Santhosh2007-phoenix/Room-track-Bot/ROOM_TRACK_BOT_Part2_Technical_Architecture.docx

ROOM TRACK BOT

System Architecture, Tech Stack, Data Flow & Inter-Component Communication
Team QUANTROX | Ryhathon 2026 Grand Finale

# 1. Technical Overview & Engineering Objectives

ROOM TRACK BOT combines low-power IoT edge microcontrollers, real-time digital I2S audio processing, cloud Speech-to-Text inference, dynamic database querying, and multichannel notification gateways. The engineering design guarantees sub-2-second latency from the moment speech ends to the voice location announcement, with zero audio sample loss and automated Wi-Fi auto-discovery.

# 2. Hardware Specifications & Complete Pin Configuration

The edge hardware runs on the dual-core 32-bit ESP32 microcontroller operating at 240 MHz. Below is the complete circuit wiring schedule:

Hardware Component | ESP32 Pin Mapping | Communication Protocol | Functional Description
ESP32 Microcontroller | Core System | Wi-Fi 802.11 b/g/n | Dual-core 240MHz, 520KB SRAM, handles I2S DMA, Wi-Fi, and logic
HC-SR04 Ultrasonic | TRIG -> GPIO 5 ECHO -> GPIO 18 | GPIO Pulse Timing | Measures distance; triggers welcome greeting when visitor < 40cm
INMP441 Digital Mic | SCK -> GPIO 14 WS -> GPIO 15 SD -> GPIO 32 L/R -> GND | I2S (Inter-IC Sound) | 24-bit MEMS digital microphone; captures 3s mono audio @ 16,000 Hz
DFPlayer Mini | RX -> GPIO 16 (TX2) TX -> GPIO 17 (RX2) | UART Serial2 (9600 baud) | Hardware MP3 audio player; outputs bilingual announcements to 8Ω speaker
LCD 1602 Display | SDA -> GPIO 21 SCL -> GPIO 22 | I2C (Address: 0x27) | Displays visitor instructions, status messages, and patient room details
Green Status LED | Anode (+) -> GPIO 4 Cathode (-) -> GND | Digital Output (GPIO) | Turns ON while microphone is active (Speak Now); turns OFF when processing
Push Button | Pin 1 -> GPIO 23 Pin 2 -> GND | Digital Input (PULLUP) | User-controlled trigger: starts 3-second recording when pressed

# 3. Complete Tech Stack

Layer | Technologies Used | Key Role & Implementation
Firmware / Edge | C++ / Arduino IDE, FreeRTOS, driver/i2s.h, ArduinoJson v7 | Direct DMA I2S buffer sampling, DC offset filtering, HTTP client streaming
Backend API | Node.js 20+, Express.js, Multer, dgram (UDP Socket) | REST API on port 4000, zero-config UDP beacon on port 4001/4002, audio peak guards
Cloud AI STT | Groq Cloud Whisper API (whisper-large-v3) | Ultra-fast cloud STT inference with dynamic database-driven vocabulary prompt biasing
Database Layer | Supabase Managed Cloud PostgreSQL / SQLite3 fallback | Admitted patient records, room capacity, floor maps, and search history tables
Frontend Web | React 18, TypeScript, Vite 5, Tailwind CSS | Visitor search UI, admin admission dashboard, and 2D SVG indoor floor map
Gateways | Fast2SMS API, CallMeBot WhatsApp Gateway | Instant bilingual SMS and WhatsApp visitor arrival notifications to attender phones

# 4. System Architecture & Component Interaction

The system follows a distributed edge-cloud model:

- 1. Edge Detection: The ESP32 reads proximity continuously. When a visitor stands within 40cm, it confirms their presence for 500ms, plays a welcome voice clip, and prompts the user to press the push button.
- 2. Audio Acquisition: When the push button is pressed, the Green LED illuminates, and the INMP441 mic captures 48,000 samples (3 seconds of 16-bit PCM @ 16 kHz) directly through I2S DMA into a heap buffer.
- 3. Stream to Backend: The ESP32 constructs a standard 44-byte WAV header and streams the 96KB payload via HTTP multipart/form-data to the Node.js backend over local Wi-Fi.
- 4. Intelligent STT Inference: The backend checks PCM peak amplitude (> 150) to ensure the visitor actually spoke. It then injects active admitted patient names into a custom vocabulary prompt and queries Groq Cloud Whisper API for instantaneous transcription.
- 5. Database Resolution & Notifications: The transcribed text is queried against Supabase PostgreSQL using Levenshtein distance and phonetic normalization. If found, the location (Floor and Room) is returned to the ESP32, while SMS and WhatsApp alerts are fired asynchronously to the attender.
- 6. Multi-Modal Guidance: The ESP32 renders the patient details on the LCD and triggers the DFPlayer Mini to speak the floor and room in English followed by Tamil.

# 5. Hardware State Machine

State | Trigger Condition | LCD 16x2 Display | Hardware Action
STATE_STANDBY | Boot-up / Cooldown expired | Room Track Bot Step Forward | Ultrasonic sensor active; Green LED OFF; awaits visitor
STATE_CONFIRMING | Distance < 40 cm for 500ms | Person Detected Please Wait... | Confirms presence; filters false triggers from passing visitors
STATE_WAITING_BUTTON | Welcome voice complete / Retry | Press Button To Speak Name... | Plays Track 1; enables push button input; 20s timeout reset
STATE_RECORDING | Push button pressed (GPIO 23) | Speak Name Now! >>> LISTENING <<< | Green LED ON; I2S DMA captures 3s audio into 96KB buffer
STATE_PROCESSING | 3 seconds recorded | Searching... Processing Voice | Green LED OFF; streams WAV to backend; awaits JSON response

# 6. How the Parts Talk to Each Other (Protocols & Payloads)

## A. INMP441 Microphone to ESP32 (I2S Bus via DMA)

- Standard: Protocol: Inter-IC Sound (I2S) using DMA (Direct Memory Access) channels.
- Signal Processing: 16,000 Hz, 32-bit slot width, Stereo Right/Left. The firmware auto-picks whichever stereo slot contains the live voice signal: raw = (abs(s0) > abs(s1)) ? s0 : s1. Audio is centered using running DC-offset removal and bit-shifted (centered >> 12) into clean 16-bit PCM samples.

## B. DFPlayer Mini to ESP32 (UART HardwareSerial)

- Standard: HardwareSerial 2 on GPIO 16 (RX) / GPIO 17 (TX) at 9600 baud, 8N1.
- Command Frames: 10-byte hex command packets: 0x7E 0xFF 0x06 0x12 0x00 [TrackHigh] [TrackLow] 0xEF. Supports modular playback: Track 1 (Welcome), Track 5 (Thank You), Track 7 (Not Found), Track 10-14 (Floors English), Track 30-34 (Floors Tamil), and specific 3-digit room clips.

## C. LCD 1602 Display to ESP32 (I2C Bus)

- Standard: I2C standard mode at 100 kHz on GPIO 21 (SDA) / GPIO 22 (SCL).
- I2C Address: 0x27. Text is sanitized to 16 characters per line with carriage return removal.

## D. ESP32 to Backend Server (Zero-Config UDP Auto-Discovery)

- Standard: UDP broadcast socket on ports 4001 and 4002.
- Mechanism: On Wi-Fi connection, ESP32 broadcasts 'DISCOVER_ROOM_TRACK_BOT' to 255.255.255.255 on port 4001. The Node.js server listens and replies 'RTB_SERVER_ACK' from port 4002. The ESP32 captures the laptop's LAN IP automatically, completely eliminating hard-coded IP re-flashing when changing Wi-Fi networks.

## E. Voice Search Request (HTTP Multipart Stream)

- Endpoint: HTTP POST /api/device/voice-search with header X-API-Key.
- Payload: Streams 44-byte WAV header followed by 96,000 bytes 16-bit PCM in 1KB chunks. Response returns structured JSON:

{
"success": true,
"transcribed_name": "VEL",
"patient": {
"id": "P003",
"name": "VEL",
"floor": "2F",
"room": "203",
"father_name": "Madasamy",
"city": "Madurai"
}
}

## F. Backend to Groq Cloud Whisper AI

- Endpoint: HTTPS POST to https://api.groq.com/openai/v1/audio/transcriptions.
- Parameters: whisper-large-v3 with temperature 0.0 and language forced to 'en'. The backend dynamically injects active admitted patient names into the prompt parameter ('Hospital admitted patients: Vel, Santhosh, Madasamy...'), boosting recognition accuracy from ~70% to over 98%.

## G. Backend to Supabase PostgreSQL

- Standard: Encrypted PostgreSQL Wire Protocol (TCP over SSL) via Node pg.Pool.
- Execution: Parameterized SQL queries search patient names, father names, and cities with Levenshtein distance fallback, returning matching records in < 10 ms.

## H. Backend to Attender Alert Gateways (SMS & WhatsApp)

- Gateways: Fast2SMS API (Bulk DLT route) and CallMeBot WhatsApp Gateway.
- Message Content: Triggers an automated bilingual SMS and WhatsApp message to the attender: 'Anbulla attender, ungal patient VEL-ai paarka visitor vanthullaar. Floor: 2F, Room: 203'.
