Santhosh2007-phoenix/Room-track-Bot/ROOM_TRACK_BOT_Circuit_and_Block_Diagrams.docx

ROOM TRACK BOT

Block Diagram, Circuit Schematics & Complete Hardware Wiring Guide
Team QUANTROX | Ryhathon 2026 Grand Finale

# 1. System Block Diagram

The ROOM TRACK BOT hardware edge unit is built around the dual-core ESP32 microcontroller. The system is segregated into four functional domains: (1) Sensing & User Trigger, (2) Audio Processing & I2S Acquisition, (3) Visual & Bilingual Audio Guidance, and (4) Cloud Networking.

+---------------------------------------------------------------------------------------+

| ROOM TRACK BOT - SYSTEM BLOCK DIAGRAM |

+---------------------------------------------------------------------------------------+

[ POWER INPUT: 5V DC via Micro-USB / External 5V 2A Regulated Adapter ]

+-------------------+--------------------+--------------------+

| (5V) | (5V) | (5V) | (3.3V)

v v v v

+------------+ +------------+ +------------+ +---------------+

| HC-SR04 | | DFPLAYER | | LCD 1602 | | INMP441 |

| ULTRASONIC | | MINI AUDIO | | (I2C 0x27) | | DIGITAL MIC |

+------------+ +------------+ +------------+ +---------------+

| (Trig/Echo) | (UART Serial2) | (I2C Bus) | (I2S DMA Bus)

| GPIO 5, 18 | GPIO 16, 17 | GPIO 21, 22 | GPIO 14, 15, 32

v v v v

+---------------------------------------------------------------------------+

| ESP32-WROOM-32 MAIN CONTROLLER |

| (Dual-Core Xtensa LX6 @ 240 MHz, 520 KB SRAM, Wi-Fi 802.11 b/g/n) |

+---------------------------------------------------------------------------+

^ ^ ^

| (Active LOW) | (Digital Out) | (2.4 GHz Wi-Fi)

| GPIO 23 | GPIO 4 | HTTP REST / UDP

| | v

+------------+ +------------+ +------------------------------------+

| PUSH BUTTON| | STATUS LED | | NODE.JS BACKEND SERVER (:4000) |

| (INPUT_ | | (Green - | | - Groq Cloud Whisper STT AI |

| PULLUP) | | Speak Now) | | - Supabase PostgreSQL DB |

+------------+ +------------+ | - Fast2SMS & WhatsApp Alerts |

+------------------------------------+

# 2. Comprehensive Pin-to-Pin Circuit Connection Schedule

Every connection between the ESP32 and peripheral sensors, actuators, and power rails is specified below:

Module / Sensor | Module Pin | ESP32 Pin | Signal / Protocol | Circuit Notes & Resistors
HC-SR04 Ultrasonic | VCC GND TRIG ECHO | 5V (VIN) GND GPIO 5 GPIO 18 | Power (5V) Ground Digital Output Pulse Input (3.3V) | ECHO pin uses a 1kΩ / 2kΩ voltage divider to step 5V down to safe 3.3V for ESP32.
INMP441 Digital Mic | VDD GND SCK WS SD L/R | 3.3V GND GPIO 14 GPIO 15 GPIO 32 GND | Power (3.3V ONLY) Ground I2S BCLK I2S LRCK I2S DIN Channel Select | Connect VDD ONLY to 3.3V. Connecting to 5V will burn the MEMS sensor. L/R to GND configures Left channel mono.
DFPlayer Mini | VCC GND RX TX SPK_1 SPK_2 | 5V (VIN) GND GPIO 17 (TX2) GPIO 16 (RX2) Speaker (+) Speaker (-) | Power (5V) Ground UART Serial2 In UART Serial2 Out Analog Audio Out Analog Audio Out | ESP32 TX (GPIO 17) connects to DFPlayer RX through a 1kΩ resistor to eliminate audio noise. Connects to 8Ω 2W/3W speaker.
LCD 1602 (I2C Backpack) | VCC GND SDA SCL | 5V (VIN) GND GPIO 21 GPIO 22 | Power (5V) Ground I2C Data I2C Clock | PCF8574 backpack communicates at address 0x27. Contrast potentiometer on back adjusts character sharpness.
Green Status LED | Anode (+) Cathode (-) | GPIO 4 GND | Digital Output Ground | Uses 220Ω / 330Ω current-limiting resistor between GPIO 4 and LED Anode. Lights up only during voice recording.
Push Button (Voice Trigger) | Terminal 1 Terminal 2 | GPIO 23 GND | Digital Input Ground | Firmware uses pinMode(23, INPUT_PULLUP). When pressed, pin reads LOW. No external resistor needed.

# 3. Detailed Module-by-Module Circuit Schematics

## A. HC-SR04 Ultrasonic Sensor & 3.3V Logic Voltage Divider

The HC-SR04 requires 5V VCC to emit high-intensity 40 kHz ultrasonic pulses. Its ECHO pin outputs a 5V logic pulse. Because the ESP32 GPIO pins are rated for 3.3V maximum, directly connecting the 5V ECHO pulse can degrade or destroy the ESP32 pin. We implement a passive 1kΩ / 2kΩ resistive voltage divider:

+5V VCC

+-------+-------+

| HC-SR04 |

| ULTRASONIC |

| SENSOR |

+---------------+

TRIG ECHO

GPIO 5 <-----+ |

[1 kΩ Resistor (R1)]

+------> GPIO 18 (Safe 3.3V Logic)

[2 kΩ Resistor (R2)]

GND

Voltage formula: V_out = 5V * (2kΩ / (1kΩ + 2kΩ)) = 3.33V, which safely matches the ESP32 logic threshold.

## B. INMP441 Digital MEMS Microphone (I2S Audio Bus)

The INMP441 is an omnidirectional MEMS microphone with an integrated 24-bit analog-to-digital converter (ADC) and an industry-standard I2S serial audio interface. Unlike noisy analog electret microphones, it communicates digitally without picking up Wi-Fi RF interference:

ESP32 PINS INMP441 MODULE

+----------------+ +----------------+

| 3.3V |---------------->| VDD (3.3V ONLY)|

| GND |---------------->| GND |

| GPIO 14 (BCLK) |---------------->| SCK (Clock) |

| GPIO 15 (LRCK) |---------------->| WS (Word Select|

| GPIO 32 (DIN) |<----------------| SD (Serial Data|

| GND |---------------->| L/R (Left Ch) |

+----------------+ +----------------+

- Important Wiring Note: VDD must connect to 3.3V only (never connect to 5V).
- Important Wiring Note: L/R pin tied to GND sets the microphone output to the Left channel stereo slot.

## C. DFPlayer Mini Audio Player & 8Ω Speaker

The DFPlayer Mini decodes MP3 files from a micro-SD card and outputs amplified analog audio directly to a 2W or 3W 8Ω speaker:

ESP32 PINS DFPLAYER MINI

+----------------+ +----------------+

| 5V (VIN) |---------------->| VCC (Pin 1) |

| GND |---------------->| GND (Pin 7/10) |

| GPIO 17 (TX2) |---[ 1 kΩ ]----->| RX (Pin 2) |

| GPIO 16 (RX2) |<----------------| TX (Pin 3) |

+----------------+ | SPK_1 (Pin 6) |---+ [Speaker +]

| SPK_2 (Pin 8) |---+ [Speaker -]

+----------------+

- Crucial Audio Fix: The 1kΩ series resistor between ESP32 TX2 (GPIO 17) and DFPlayer RX absorbs voltage level differences and prevents high-frequency digital switching noise from bleeding into the speaker.

## D. LCD 1602 Display with PCF8574 I2C Backpack

The 16-character by 2-line alphanumeric LCD uses a PCF8574 I2C backpack board, reducing the required control lines from 16 to just 2 I2C wires:

ESP32 PINS LCD 1602 (I2C)

+----------------+ +----------------+

| 5V (VIN) |---------------->| VCC |

| GND |---------------->| GND |

| GPIO 21 (SDA) |---------------->| SDA |

| GPIO 22 (SCL) |---------------->| SCL |

+----------------+ +----------------+

- Adjustment: The onboard potentiometer on the blue backpack adjusts the contrast of the 16x2 text. If blank blocks appear, rotate the trimmer with a screwdriver.

## E. Green Indicator LED (Speak Now Visual Cue)

ESP32 GPIO 4 ----[ 220 Ω / 330 Ω Resistor ]----( + ) LED Anode

( - ) LED Cathode ---- GND

- Operation: Software logic: Turns ON at the start of recordAndSearchVoice() and turns OFF immediately when 3 seconds finish.

## F. Push Button (Voice Input Trigger)

ESP32 GPIO 23 ----[ Push Button Switch ]---- GND

(Internal pull-up resistor enabled: pinMode(23, INPUT_PULLUP))

- Operation: When unpressed: GPIO 23 reads HIGH (3.3V). When pressed: GPIO 23 reads LOW (0V). Software debounces with a 150ms delay.

# 4. Power Architecture & Decoupling Strategy

The system uses a single unified 5V DC power supply (Micro-USB or 5V 2A wall adapter):

- 5V Distribution: 5V Rail: Powers the DFPlayer Mini (needs high peak current during speaker audio bursts), the LCD 1602 backlight, and the HC-SR04 ultrasonic sensor.
- 3.3V Distribution: 3.3V Rail: Generated by the ESP32's onboard AMS1117 / ME6211 low-dropout (LDO) regulator. Powers the ESP32 microcontroller core and the INMP441 digital microphone.
- Common Ground Bus: Common Ground (GND): All grounds (ESP32 GND, Sensor GND, DFPlayer GND, LCD GND, and Button GND) are tied to a single common ground bus to avoid floating ground loops and audio buzz.
