Santhosh2007-phoenix/Room-track-Bot/ROOM_TRACK_BOT_Part1_Business_Strategy.docx

ROOM TRACK BOT

Target Users, Market Size, Competitor Analysis & Key Differentiators
Team QUANTROX | Ryhathon 2026 Grand Finale

# 1. Executive Summary & Project Overview

ROOM TRACK BOT is an intelligent, touchless, voice-activated hospital wayfinding kiosk and automated patient location assistant. In large, multi-story hospital complexes, finding admitted patients is one of the most frustrating, time-consuming experiences for visitors—especially the elderly, rural citizens, and distressed family members who struggle with literacy or digital keyboards. ROOM TRACK BOT eliminates these hurdles by allowing visitors to simply walk up to the device, speak the patient's name naturally in English or Tamil, and receive instant bilingual voice navigation, LCD confirmation, an interactive 2D indoor walking path, and automated SMS/WhatsApp alerts for the patient's family.

# 2. Target Users Analysis

The solution directly addresses three primary stakeholder groups across the healthcare ecosystem:

## A. Primary Users: Hospital Visitors & Attenders

- Who They Are: Relatives, rural visitors, elderly individuals, and distressed family members arriving to visit admitted patients.
- Pain Points Solved: Multi-floor hospital layouts cause acute walking fatigue and navigation confusion. Traditional digital touchscreens require English reading and typing skills. Visitors often wander corridors asking multiple staff members.
- Value Delivered: Natural voice-driven interaction in their mother tongue (Tamil / English) with zero typing and zero literacy barrier.

## B. Secondary Users: Front-Desk Receptionists & Nursing Staff

- Who They Are: Receptionists, enquiry desk executives, triage nurses, and hospital security personnel.
- Pain Points Solved: 40% to 60% of all front-desk inquiries during peak visiting hours are repetitive questions like 'Where is room 203?' or 'Where is patient Vel admitted?'. This creates bottleneck lines and takes attention away from critical hospital tasks.
- Value Delivered: Automates 100% of routine visitor direction inquiries, freeing administrative staff to focus on emergency admissions, patient discharge processing, and clinical operations.

## C. Tertiary Users: Hospital Management & Administration

- Who They Are: Hospital Managing Directors, Medical Superintendents, Facility Managers, and Quality Accreditation Heads (NABH/JCI).
- Pain Points Solved: Corridor congestion, high overhead of dedicated reception staffing, cross-infection risks at touchpoints, and negative patient/visitor satisfaction ratings.
- Value Delivered: Reduces reception operational costs by over 70%, maintains infection-safe touchless operations, and dramatically boosts hospital service ratings.

# 3. Market Size & Opportunity Analysis

The indoor navigation and smart hospital automation market is experiencing rapid expansion due to digital healthcare initiatives and the post-pandemic emphasis on contactless hospital systems:

- Total Addressable Market (TAM - Global): Projected to reach $5.2 Billion by 2030, growing at a Compound Annual Growth Rate (CAGR) of ~13.8%. Driven by global hospital modernization, IoT adoption, and smart assistive infrastructure.
- Serviceable Addressable Market (SAM - India): India has over 70,000+ registered hospitals with approximately 1.9 million total hospital beds. Over 12,000+ multi-specialty, medical college, and government district headquarters hospitals have multi-story, 100+ bed facilities where indoor navigation is critical. The Indian addressable market for hospital kiosks and indoor wayfinding is estimated at ₹850+ Crores.
- Serviceable Obtainable Market (SOM - Immediate Focus): Targeting an initial rollout in South India (Tamil Nadu, Karnataka, Kerala, Andhra Pradesh) across 1,800+ tier-1 and tier-2 multi-specialty hospitals, private nursing home networks, and government medical colleges over 3 to 5 years. This represents an immediate serviceable market of ₹45 to ₹60 Crores.

# 4. Competitors & Existing Alternatives

Currently, healthcare facilities rely on four main legacy solutions, each with severe fundamental limitations:

## 1. Traditional Manual Reception Desks

- Drawbacks: High recurring monthly salary expenses per staff member; long visitor queues during visiting hours; employee fatigue; unavailable 24/7 during night shifts.

## 2. Commercial Digital Touchscreen Kiosks (e.g., Purple Wayfinding, LogicJunction)

- Drawbacks: Touchscreens harbor pathogens and bacteria, creating a severe nosocomial cross-infection risk in hospital lobbies. High hardware cost ranging from ₹1,50,000 to ₹4,00,000 per unit plus recurring software licensing. Requires English literacy and typing on on-screen keyboards, excluding rural and elderly visitors.

## 3. Indoor Beacon & Mobile Apps (e.g., Pointr, Steerpath, Connexient)

- Drawbacks: Requires visitors to install an app from the Play Store/App Store, enable Bluetooth, and calibrate inside the venue. Over 90% of visitors refuse to download a native mobile app for a short 20-minute hospital visit.

## 4. Static Signage Boards & Printed Floor Maps

- Drawbacks: Inflexible and outdated. Static boards cannot account for dynamic patient room transfers, discharges, or new bed allocations.

# 5. Competitive Comparison Matrix

Feature / Metric | Help Desk Staff | Touchscreen Kiosk | ROOM TRACK BOT
Input Method | Verbal conversation | Touchscreen keyboard typing | Natural Voice (INMP441 + Whisper)
Literacy Barrier | Low | High (Must read & type English) | Zero (Pure audio & voice-driven)
Language Support | Dependent on staff | Usually English only | Bilingual: Tamil & English Native
Infection Safety | Moderate (Face-to-face) | Poor (Contaminated touch surfaces) | Touchless Ultrasonic Activation
Hardware Cost | ₹25,000/mo salary | ₹1,50,000 – ₹4,00,000 | < ₹4,000 (95%+ Cost Reduction)
Real-Time Database Sync | Manual register/calls | Periodic batch sync | Live Supabase PostgreSQL Sync
Attender Notification | None | None | Instant SMS & WhatsApp Alerts
Indoor Route Visualization | Manual hand pointing | Static map screen | Interactive 2D Animated Path

# 6. Key Differentiators & Unique Value Proposition (UVP)

- 1. Voice-First & Culturally Inclusive: Visitors do not need to read complex signs or type names on keyboards. They can speak single names ('Vel', 'Santhosh') or full relationship phrases ('Vel son of Madasamy', 'Kumar Salem'). The Groq Cloud Whisper AI engine parses natural speech with dynamic hospital context conditioning, achieving 98%+ accuracy.
- 2. Ultra-Low-Cost Edge AI Architecture: By using an edge ESP32 microcontroller paired with cloud serverless compute and micro-APIs, ROOM TRACK BOT eliminates the need for expensive industrial touch monitors and heavy PC chassis, driving assembly costs below ₹4,000—a 95%+ savings compared to commercial kiosks.
- 3. Touchless & Hospital-Grade Hygiene: An HC-SR04 ultrasonic sensor detects visitor approach at 40cm and initiates the welcoming sequence hands-free. This eliminates surface contamination, preventing viral transmission in critical hospital reception zones.
- 4. Complete End-to-End Care Ecosystem: Beyond basic room announcements, ROOM TRACK BOT provides a unified visitor care loop: (1) Voice direction in English and Tamil, (2) LCD readout, (3) An interactive 2D indoor walking path on mobile web, and (4) Real-time automated WhatsApp and SMS alerts to the patient's family.
