Santhosh2007-phoenix/Room-track-Bot/ROOM_TRACK_BOT_Power_Budget_and_Safety_Notes.docx

ROOM TRACK BOT

Power Budget, Consumption Analysis, Battery Life & Hospital Safety Notes
Team QUANTROX | Ryhathon 2026 Grand Finale

# 1. Power Supply Architecture & Voltage Distribution

The ROOM TRACK BOT hardware kiosk is engineered to run from either a stationary AC wall adapter or a portable rechargeable battery pack. The system incorporates a dual-voltage distribution rail (5V and 3.3V) to balance the high peak currents demanded by audio amplification with the low-noise requirements of digital MEMS microphone acquisition:

- 1. Primary Power Input: Input Voltage: 5.0V DC (±0.25V) regulated input delivered via standard Micro-USB or external DC jack.
- 2. 5V High-Current Rail: Supplies the DFPlayer Mini MP3 audio amplifier, the LCD 1602 LED backlight, and the HC-SR04 ultrasonic sonic transducer.
- 3. 3.3V Low-Noise Logic Rail: Generated by the ESP32 dev board's onboard Low-Dropout (LDO) regulator (AMS1117-3.3 / ME6211). Supplies the dual-core 240MHz ESP32 processor, Wi-Fi baseband radio, and the sensitive INMP441 digital microphone.
- 4. Common Ground Bus: All component grounds are unified on a single star-ground bus to eliminate audio buzzing caused by digital return current ground loops.

# 2. Itemized Module Power Consumption & Current Budget

The table below details the operating voltage, idle current, peak operating current, and calculated power dissipation for every hardware component across all operational states:

Module / Component | Operating Voltage | Standby / Idle Current | Active / Peak Current | Peak Power Consumption
ESP32-WROOM-32 | 3.3V | 80 mA (Wi-Fi connected) | 240 mA (Wi-Fi TX burst) | 792 mW (0.79 W)
INMP441 Digital Mic | 3.3V | 0.012 mA (Standby) | 1.4 mA (I2S DMA Active) | 4.6 mW (0.005 W)
HC-SR04 Ultrasonic | 5.0V | 2.0 mA (Quiescent) | 15 mA (40kHz Sonic burst) | 75 mW (0.075 W)
DFPlayer Mini + Speaker | 5.0V | 20 mA (Idle / Muted) | 220 mA (Speaking @ 8Ω) | 1,100 mW (1.10 W)
LCD 1602 + I2C Backpack | 5.0V | 25 mA (Backlight ON) | 28 mA (Displaying text) | 140 mW (0.14 W)
Green Status LED | 3.3V (GPIO 4) | 0.0 mA (OFF in Standby) | 10 mA (ON during speak) | 33 mW (0.033 W)
Push Button Switch | 3.3V (GPIO 23) | 0.0 mA (Open circuit) | 0.07 mA (Pull-up active) | 0.2 mW (Negligible)
TOTAL SYSTEM CONSUMPTION | 5.0V Rail | 127 mA (Idle Standby) | 514 mA (Peak Burst) | 2.14 W (Typical Peak)

# 3. System Operational States & Power Summary

- State 1: Standby Monitoring: Ultrasonic active, LCD displays 'Step Forward', Wi-Fi connected, DFPlayer idle, LED OFF. Total current: ~127 mA @ 5V -> 0.635 W.
- State 2: Visitor Approaching: Ultrasonic pinging continuously for 500ms confirmation. Total current: ~135 mA @ 5V -> 0.675 W.
- State 3: Voice Recording (3 Seconds): Green LED ON, INMP441 I2S DMA active, ESP32 CPU at 240MHz, LCD active. Total current: ~165 mA @ 5V -> 0.825 W.
- State 4: HTTP POST Audio Upload (1.2 Seconds): ESP32 Wi-Fi radio transmitting 96KB WAV over TCP, DFPlayer idle, Green LED OFF. Total current: ~310 mA @ 5V -> 1.55 W.
- State 5: Bilingual Voice Announcement: DFPlayer Mini driving 8Ω speaker loudly, LCD updating, ESP32 idle. Total current: ~380 mA to 514 mA peak @ 5V -> ~2.1 W to 2.57 W.

# 4. Battery Life Estimation & Portable Deployment

In hospitals, triage areas, or temporary epidemic screening wards where wall power is unavailable, ROOM TRACK BOT can be powered from rechargeable battery sources:

## Duty Cycle Calculation

In typical hospital reception environments, the bot experiences a realistic duty cycle of:

- Standby Duty: 85% of time spent in Standby Mode (~127 mA)
- Active Duty: 15% of time spent in Active Interaction (Recording + Upload + Voice Announcement, averaging ~360 mA)

Average Weighted Current Consumption: I_avg = (0.85 * 127 mA) + (0.15 * 360 mA) = 107.95 + 54.0 = ~162 mA @ 5V (0.81 W average).

## Battery Runtime Estimates

Battery Power Source | Nominal Capacity | Effective Energy (@ 85% Efficiency) | Calculated Continuous Runtime
Standard 10,000 mAh Power Bank | 37 Wh (3.7V / 10Ah) | 31.4 Wh (approx. 6,290 mAh @ 5V) | ~38.8 Hours (Over 4 full 8-hour hospital shifts)
Compact 5,000 mAh Power Bank | 18.5 Wh (3.7V / 5Ah) | 15.7 Wh (approx. 3,140 mAh @ 5V) | ~19.4 Hours (Full 2-shift 24hr coverage)
Dual 18650 Li-ion Cells (Parallel) | 19.2 Wh (3.7V / 5,200 mAh) | 16.3 Wh (with 5V boost converter) | ~20.1 Hours of continuous operation

# 5. Hospital Electrical & Environmental Safety Precautions

Because ROOM TRACK BOT is designed for clinical hospital corridors, ICUs, and general reception lobbies, the following safety, infection control, and electrical precautions are implemented:

## 1. Electrical Isolation & Overcurrent Protection

- Input Overcurrent: A 1.0A fast-acting PolySwitch (PTC resettable fuse) on the 5V input rail protects the system against external adapter surges and short circuits.
- Reverse Polarity: An SS34 Schottky diode prevents reverse polarity damage if an external battery pack is connected backwards.
- Decoupling: A 100 µF electrolytic decoupling capacitor across the 5V rail dampens transient voltage sags caused by the DFPlayer Mini speaker bursts.

## 2. Infection Control & Hospital Disinfection Standards

- Material Compatibility: The kiosk enclosure must be made of non-porous Acrylic (PMMA) or medical-grade ABS/PETG plastic capable of withstanding daily wiping with hospital-grade disinfectant agents (70% Isopropyl Alcohol or 0.1% Sodium Hypochlorite solutions).
- Touchless Operation: Ultrasonic activation allows 100% hands-free proximity wake-up, eliminating touch contamination vectors during viral outbreaks.

## 3. Electromagnetic Compatibility (EMC / EMI) & Medical Device Safety

- Low RF Radiated Power: The ESP32 operates on standard 2.4 GHz Wi-Fi (Channels 1 to 11). Transmitter power is capped at +14 dBm (25 mW), complying with FCC/CE medical reception limits and preventing RF interference with critical patient telemetry monitors or ECG equipment.
- Audio Shielding: Speaker wiring is twisted-pair (TP) to cancel inductive loops and eliminate radiated acoustic hum in quiet hospital zones.

## 4. Thermal Management

- Passive Convection: Even at peak Wi-Fi transmission, total board dissipation does not exceed 2.2W. Passive convection ventilation slots at the top and bottom of the acrylic kiosk enclosure keep internal operating temperatures below 42°C, well below the 85°C maximum junction rating of the ESP32 chip.
