Santhosh2007-phoenix/Room-track-Bot/ROOM_TRACK_BOT_Bill_of_Materials_BOM.docx

ROOM TRACK BOT

Comprehensive Bill of Materials (BOM), Component Sourcing & Cost Breakdown
Team QUANTROX | Ryhathon 2026 Grand Finale

# 1. Bill of Materials (BOM) Overview

This document outlines the complete Bill of Materials (BOM) for the ROOM TRACK BOT edge kiosk unit. It details component specifications, exact quantities required per unit, unit costs, total expenditures, procurement sources (online distributors and local electronics markets), and each component's functional role in the system architecture.

# 2. Itemized Bill of Materials Table

Item # | Component & Specification | Qty | Unit Cost (INR) | Total (INR) | Sourcing / Where It Comes From
1 | ESP32-WROOM-32 Dev Module (Dual-core 240MHz, Wi-Fi+BLE, 30/38 pin) | 1 | ₹450 | ₹450 | Robu.in / Robocraze / Local Market (Ritchie St. Chennai / SP Road Bangalore) / Amazon India
2 | INMP441 I2S MEMS Digital Microphone Module (Omnidirectional, 24-bit) | 1 | ₹280 | ₹280 | ElectronicsComp.com / Robu.in / Robocraze / Tanotis
3 | HC-SR04 Ultrasonic Distance Sensor Module (2cm to 400cm range) | 1 | ₹90 | ₹90 | Robu.in / ElectronicsComp / Local Hobby Electronics Shop
4 | DFPlayer Mini MP3 Audio Decoder Module (UART Serial, 24-bit DAC) | 1 | ₹160 | ₹160 | Robu.in / Robocraze / Amazon India / Local Hobby Store
5 | LCD 1602 Alphanumeric Display with PCF8574 I2C Backpack (Blue Backlight) | 1 | ₹220 | ₹220 | Robu.in / ElectronicsComp / Local Electronics Market
6 | Micro SD Card 16GB Class 10 (SanDisk / Kingston, FAT32 Formatted) | 1 | ₹260 | ₹260 | Amazon India / Local Computer Stationery / Flipkart
7 | 8 Ohm 2W / 3W Internal Mini Dynamic Speaker (with wire leads) | 1 | ₹65 | ₹65 | Robu.in / ElectronicsComp / Local Audio Repair Shop
8 | Green 5mm Diffused LED (Status 'Speak Now' indicator) | 1 | ₹3 | ₹3 | Local Component Retailer / ElectronicsComp
9 | 12x12mm Tactile Push Button Switch with Round Cap (Voice Trigger) | 1 | ₹10 | ₹10 | Robu.in / Local Component Shop
10 | Precision Metal Film Resistors (220Ω, 1kΩ, 2kΩ 1/4W pack of 5) | 1 set | ₹10 | ₹10 | Local Electronics Parts Store / Robu.in
11 | MB-102 Solderless Breadboard (830 tie-points) / FR4 Perfboard PCB | 1 | ₹120 | ₹120 | Robu.in / Robocraze / Amazon India
12 | Premium Dupont Jumper Wires (40-pin Male-to-Male & Male-to-Female bundle) | 1 set | ₹70 | ₹70 | Robu.in / Amazon India
13 | 5V 2A DC Regulated Power Adapter & 1m Micro-USB Power Cable | 1 | ₹220 | ₹220 | Local Mobile Accessories Store / Amazon India
14 | Custom Desktop Kiosk Enclosure (Laser-cut Acrylic / 3D Printed PLA) | 1 | ₹350 | ₹350 | Local 3D Printing Service / Robocraze / Acrylic Fabrication Vendor
TOTAL | | | ₹2,318 | (Approx. $28.00 USD)

# 3. Detailed Functional Breakdown of Each Component

## 1. ESP32-WROOM-32 Microcontroller (₹450)

- Specification: Dual-core Xtensa 32-bit LX6 running at 240 MHz with 520 KB SRAM and built-in 802.11 b/g/n Wi-Fi.
- Functional Role: Acts as the brain of the edge unit. Coordinates proximity polling, triggers I2S DMA memory buffers, manages button interrupts, streams audio to the backend via HTTP, and communicates with the LCD and DFPlayer Mini.
- Procurement: Robu.in / Robocraze / ElectronicsComp / Local Electronics Market.

## 2. INMP441 I2S Digital MEMS Microphone (₹280)

- Specification: 24-bit integrated sigma-delta ADC, 61 dBA SNR, omnidirectional, I2S direct digital output.
- Functional Role: Captures visitor speech directly in digital PCM format over I2S. Eliminates analog noise, grounding hum, and Wi-Fi RF interference that plague traditional analog electret microphones.
- Procurement: ElectronicsComp.com / Robu.in / Tanotis.

## 3. HC-SR04 Ultrasonic Distance Sensor (₹90)

- Specification: 40 kHz sonic transducer, 2cm to 400cm range with 3mm precision.
- Functional Role: Provides hands-free touchless visitor detection. When a visitor approaches within 40 cm for 500ms, it initiates the greeting sequence hands-free to prevent infection spread.
- Procurement: Robu.in / Robocraze / Local hobby shops.

## 4. DFPlayer Mini Audio Player & 8Ω Speaker (₹225 combined)

- Specification: Hardware MP3/WAV decoding chip with 24-bit DAC output, driving an 8Ω 2W/3W mini speaker.
- Functional Role: Announces clear bilingual spoken navigation in Tamil and English (Floor numbers, room numbers, and patient confirmations) stored on a Micro-SD card.
- Procurement: Robu.in / Amazon India / Local component stores.

## 5. LCD 1602 Display with PCF8574 I2C Backpack (₹220)

- Specification: 16 characters by 2 lines alphanumeric LCD, 5V operating voltage, address 0x27 over I2C.
- Functional Role: Displays dynamic real-time status cues ('Step Forward', 'Press Button', 'Listening...', 'Searching...') and final patient location confirmation ('VEL / 2F Room:203').
- Procurement: ElectronicsComp / Robu.in / Local markets.

## 6. Green Indicator LED & Tactile Push Button (₹13 combined)

- Specification: 5mm diffused LED and 12x12mm momentary tactile switch.
- Functional Role: Provides clear user feedback. The push button allows visitors to control when they speak; the green LED illuminates during recording and turns off when processing.
- Procurement: Local electronic component retailers.

## 7. Power Supply, Chassis & Passives (₹720 combined)

- Specification: 5V 2A power adapter, 1kΩ/2kΩ/220Ω precision resistors, breadboard/PCB, jumper wires, and custom acrylic desktop housing.
- Functional Role: Delivers stable power, protects the ESP32 input pin via voltage division, and encloses the hardware in a clean, hospital-ready countertop enclosure.
- Procurement: Local mobile accessory retailers, local 3D print/acrylic fabrication workshops.

# 4. Cost Comparison: ROOM TRACK BOT vs Commercial Kiosks

The table below demonstrates the dramatic economic advantage of ROOM TRACK BOT compared to conventional healthcare wayfinding kiosks:

Comparison Metric | Commercial Touchscreen Kiosk | ROOM TRACK BOT (QUANTROX)
Hardware Unit Cost | ₹1,50,000 to ₹3,50,000 per unit | ₹2,318 (Prototype) / < ₹1,800 (Mass Production)
Annual Software / SaaS Fee | ₹35,000 to ₹80,000 per year | ₹0 (Open-source Node.js + Supabase free tier)
Deployment Cost for 10 Wards | ₹15,00,000 to ₹35,00,000 | ₹23,180 total (Over 98% Capital Savings)
Maintenance & Spares | Expensive proprietary displays & touch controllers | Off-the-shelf, modular, easily replaceable components
Power Consumption | 150W – 300W (Heavy PC + large bright display) | < 2.5W (Ultra-low power edge microcontroller)
