Santhosh2007-phoenix/Room-track-Bot/ROOM_TRACK_BOT_Firmware_Logic_and_Failure_Handling.docx

ROOM TRACK BOT

Firmware Architecture, Logic Flowchart, State Machine & Failure Handling
Team QUANTROX | Ryhathon 2026 Grand Finale

# 1. Firmware Architecture & Execution Model

The ROOM TRACK BOT firmware (RoomTrackBot.ino) is engineered for high stability on the ESP32 microcontroller. It leverages FreeRTOS non-blocking event loops, hardware I2S DMA audio buffering, UART serial command queues, and hardware timer checks. The system operates as a deterministically driven Finite State Machine (FSM) ensuring that sensor sampling, user push-button interactions, cloud API calls, and audio playback never block each other or cause watchdog timer (WDT) resets.

# 2. High-Level Firmware Logic Flowchart

+-----------------------------------------------------------------------------------------+

| FIRMWARE LOGIC & EXECUTION FLOWCHART |

+-----------------------------------------------------------------------------------------+

[ POWER ON / BOOT ]

Initialize Serial(115200), I2C(0x27), DFPlayer,

I2S DMA Driver(16kHz), GPIO 4(LED), GPIO 23(BTN)

[ CONNECT TO WI-FI ]

[ UDP AUTO-DISCOVERY (Port 4001/4002) ]

(Broadcasts beacon, captures server LAN IP)

v

+---------------------------------------+

+--------------------->| STATE_STANDBY |<---------------------+

| | LCD: 'Room Track Bot / Step Forward' | |

| +---------------------------------------+ |

| Distance < 40 cm? |

| | YES |

| v |

| +---------------------------------------+ |

| | STATE_CONFIRMING_PERSON | |

| | LCD: 'Person Detected / Please Wait' | |

| +---------------------------------------+ |

| Confirmed for 500 ms? (Anti-bounce) |

| / \ |

| NO (False alarm) YES |

+--------------------------------- | |

v |

Plays Track 1 (Welcome Voice) |

LCD: 'Welcome to Room Track Bot' |

v |

+---------------------------------------+ |

+--------------------->| STATE_WAITING_FOR_BUTTON | |

| | LCD: 'Press Button To / Speak Name' | |

| +---------------------------------------+ |

| Visitor walks away (> 80cm) Push Button Pressed (GPIO 23 LOW) |

| OR 20-second timeout | |

| | v |

| | +---------------------------------------+ |

| | | STATE_RECORDING | |

| | | - Green LED: ON | |

| | | - LCD: 'Speak Name Now / LISTENING' | |

| | | - I2S captures 48,000 samples (3 sec) | |

| | +---------------------------------------+ |

| | 3 Seconds Elapsed -> Green LED OFF |

| | Peak Volume < 150? |

| | / \ |

| | YES (Silence) NO (Audio OK) |

| | LCD: 'No Voice Heard!' v |

| | Plays Track 7 +-----------------------------------+ |

| +----------+ | STATE_PROCESSING | |

| | LCD: 'Searching / Processing' | |

| | Streams WAV via HTTP POST | |

| +-----------------------------------+ |

| Backend AI STT + DB Query Result |

| / \ |

| NOT FOUND FOUND |

| LCD: 'Patient Not Found' v |

| Plays Track 7 LCD: Name, Floor, |

| | Room Number |

| | DFPlayer: Bilingual

| | Location Voice |

| | LCD: 'Thank You!' |

| | 6s Cooldown |

+----------------------------------------------------+ +--------+

# 3. Detailed Finite State Machine (FSM) Breakdown

The system behavior is governed by five well-defined states. The exact inputs monitored, outputs generated, and transition conditions for each state are detailed below:

## 1. STATE_STANDBY

- Entry Condition: System power-on boot complete, or previous visitor transaction cooldown has finished.
- Inputs Monitored: HC-SR04 ultrasonic echo pulse width (calculated distance in centimeters).
- Outputs & Signals: LCD Line 1: 'Room Track Bot', LCD Line 2: 'Step Forward'. Green LED is forced LOW (OFF). DFPlayer Mini is idle. Background Wi-Fi health and website visitor queue polling (/device/next-patient) run every 2 seconds.
- Transition: If measured distance is between 1 cm and 40 cm, records timestamp and transitions to STATE_CONFIRMING_PERSON.

## 2. STATE_CONFIRMING_PERSON

- Entry Condition: Ultrasonic sensor detected an object/person closer than 40 cm.
- Inputs Monitored: Continuous ultrasonic distance checks over a 500-millisecond time window.
- Outputs & Signals: LCD Line 1: 'Person Detected', LCD Line 2: 'Please Wait...'.
- Transition: If distance stays under 45 cm for 500 ms continuously: Plays Track 1 (Welcome Voice message), waits for audio duration, and transitions to STATE_WAITING_FOR_BUTTON. If the visitor moves away before 500 ms (false alarm / passerby), reverts instantly to STATE_STANDBY.

## 3. STATE_WAITING_FOR_BUTTON

- Entry Condition: Welcome audio finished playing, OR patient search resulted in 'NOT FOUND' (retry loop).
- Inputs Monitored: GPIO 23 digital state (Push Button connected to GND with internal pull-up); Ultrasonic distance for visitor presence.
- Outputs & Signals: LCD Line 1: 'Press Button To', LCD Line 2: 'Speak Name...' (or 'Try Again...' on retry). Green LED is OFF.
- Transition: If GPIO 23 reads LOW: Debounces for 150 ms, waits for release, and transitions to STATE_RECORDING. If visitor walks away (distance > 80 cm or 999 cm) for 20 continuous seconds: Aborts session and resets to STATE_STANDBY.

## 4. STATE_RECORDING

- Entry Condition: Visitor pressed the voice trigger push button on GPIO 23.
- Inputs Monitored: Digital I2S audio frames from INMP441 microphone (DMA chunks of 256 samples @ 32-bit slot width).
- Outputs & Signals: Green LED on GPIO 4 turns HIGH (illuminated). LCD Line 1: 'Speak Name Now!', LCD Line 2: '>>> LISTENING <<<'. I2S DMA buffer is flushed; 48,000 samples (3 seconds of 16-bit PCM @ 16 kHz) are recorded into a 96,000-byte heap buffer.
- Transition: Once 3 seconds elapse: Green LED turns LOW (OFF). Computes audio peak volume. If peak < 150 (silence): Displays 'No Voice Heard!', plays Track 7, frees memory, and loops back to STATE_WAITING_FOR_BUTTON. If speech detected (peak >= 150): Transitions to STATE_PROCESSING.

## 5. STATE_PROCESSING

- Entry Condition: 3 seconds of valid spoken audio captured.
- Inputs Monitored: HTTP 1.1 socket response stream from backend server (/api/device/voice-search).
- Outputs & Signals: LCD Line 1: 'Searching...', LCD Line 2: 'Processing Voice'. ESP32 formats a 44-byte WAV header and streams the 96KB payload via HTTP multipart/form-data.
- Transition: Parses JSON response. (A) If Success (Match Found): LCD displays patient name, floor, and room; DFPlayer Mini announces bilingual location (English + Tamil); LCD shows 'Thank You!'; sets 6-second cooldown; transitions to STATE_STANDBY. (B) If Not Found: LCD displays heard name + 'Patient Not Found'; DFPlayer plays Track 7; frees buffer; transitions directly back to STATE_WAITING_FOR_BUTTON for an immediate retry.

# 4. Comprehensive Failure Handling & Fault Recovery

To guarantee 24/7 autonomous hospital operation without requiring technician reboots, the firmware embeds resilient fault recovery mechanisms for every possible failure mode:

Failure Scenario | Root Cause / Detection | Device Behavior & Output | Self-Healing / Recovery Path
1. Wi-Fi Disconnection | Router reboot, hotspot range drop, or beacon loss. Detected via WiFi.status() != WL_CONNECTED. | LCD displays 'Connecting WiFi'. Audio playback is maintained locally; website polling pauses. | Firmware triggers WiFi.reconnect(). Once reconnected, it automatically executes UDP Auto-Discovery to refresh server IP.
2. Backend Server Offline / IP Changed | Laptop IP changed due to DHCP lease renewal, or backend stopped. HTTP connect fails or times out (8s). | LCD shows 'Server Connect / Failed' for 2 seconds. Green LED turns OFF. | Frees audio buffer, triggers discoverServerIP() UDP broadcast on ports 4001/4002 to re-discover server, and resets to button prompt.
3. Pure Silence / Inaudible Voice | Visitor pressed button but remained silent or spoke too far from mic. Detected: peakVolume < 150. | LCD displays 'No Voice Heard! / Speak Louder...'. DFPlayer plays prompt Track 7. | Does not upload silent audio to Groq Whisper (avoids API cost & hallucination). Loops back to STATE_WAITING_FOR_BUTTON.
4. Patient Not Found in Database | Spoken name does not match any admitted patient. Backend returns { success: false, transcribed_name: 'xyz' }. | LCD shows 'Heard: xyz / Patient Not Found'. DFPlayer Mini plays Track 0007.mp3 ('Person Not Found'). | Frees buffer and immediately resets to STATE_WAITING_FOR_BUTTON ('Press Button To Try Again...'). Visitor can retry without walking away.
5. Visitor Walks Away (Abandonment) | Visitor triggered welcome greeting but walked away without pressing button. Monitored via ultrasonic > 80cm. | System waits 20 seconds. If distance > 80cm or timeout expires, logs 'Button wait timeout'. | Automatically calls setStandbyScreen(), clearing LCD and returning to STATE_STANDBY for the next visitor.
6. Out of Memory (Heap Allocation) | malloc(96000) fails due to fragmented internal SRAM heap. | Green LED turns OFF immediately. LCD displays 'Memory Error / Out of RAM' for 2 seconds. | Gracefully aborts recording, frees temporary pointers, and returns to standby. Does not crash or trigger kernel panic.
7. DFPlayer Mini Unresponsive | Micro-SD card missing, unseated, or serial line disconnected. player.begin() returns false. | Serial logs 'WARN: DFPlayer not ready!'. LCD remains 100% operational. | Firmware checks playerReady flag before every playTrack() call. Silently bypasses audio delays so visual guidance continues.
