Santhosh2007-phoenix/Room-track-Bot/(commit log)

2026-10-11 Room Track Bot full stack commit
2026-10-12 Add followRedirects and detailed error logging for ESP32
2026-10-12 Optimize ESP32 SSL polling, add redirect support and 15s timeout
2026-10-12 Switch to ultra-fast local HTTP proxy on Port 5173
2026-10-14 Update ESP32 local proxy API_BASE to 10.31.207.79
2026-10-14 Switch ESP32 to direct Cloud Backend with WiFiClientSecure
2026-10-14 Add 5F support in floorIndex and track durations
2026-10-14 Update Patient to Person in LCD and Bluetooth messages
2026-10-14 Set exact measured millisecond durations for all generated MP3s
2026-10-14 Assign exact individual millisecond durations for each room track
2026-10-14 Add render.yaml blueprint, HTTPS ESP32 support, and 66 MP3 audio files
2026-10-14 Remove setBufferSizes to fix ESP32 WiFiClientSecure compilation
2026-10-15 Add permanent UDP auto-discovery: ESP32 automatically finds laptop server on any Wi-Fi
2026-10-15 Support multiple patient results on visitor search
2026-10-15 feat: add father_name and city/village details across DB, APIs, Visitor website, Admin panel, and ESP32 Bluetooth
2026-10-21 fix: update IP to 10.63.11.79 and SSID to Santhosh 14 in ESP32 firmware
2026-10-21 feat: remove staff login & send-to-bot from visitor app, add send-to-bot to staff dashboard & patient actions
2026-10-29 Support combined patient name, father name and city in visitor and voice search
2026-10-29 Update ESP32 firmware with INMP441 I2S voice recording and ultrasonic trigger
2026-10-29 Auto-detect INMP441 audio channel and boost gain; add prompt and silence filter to Whisper STT
2026-10-29 Prioritize patient name match over city and support stem matching (e.g. Veli matches Vel)
2026-10-29 Fix INMP441 audio channel locking, add dynamic Whisper vocab prompt & intelligent fuzzy patient matching
2026-10-29 Add Green LED indicator: ON during Speak Now, OFF during Processing
2026-10-29 Add Interactive 2D Indoor Hospital Floor Map & Wayfinding route for Track Person
2026-10-29 Show original patient location card first and place Track Person button cleanly underneath
2026-10-29 Remove Dispatch to Room Track Bot button from floor map modal
2026-10-29 Change GREEN_LED_PIN from strapping pin GPIO 2 to safe GPIO 4
2026-10-29 Implement 4-step workflow: Welcome screen/voice, push-button triggered speech on GPIO 23, found announcement, and retry loop on not-found
2026-10-29 Filter visitor search to exact patient name and add full project Word documentation
